Picatout/machineathe/documents/extérieur panneau contrôle.JPG

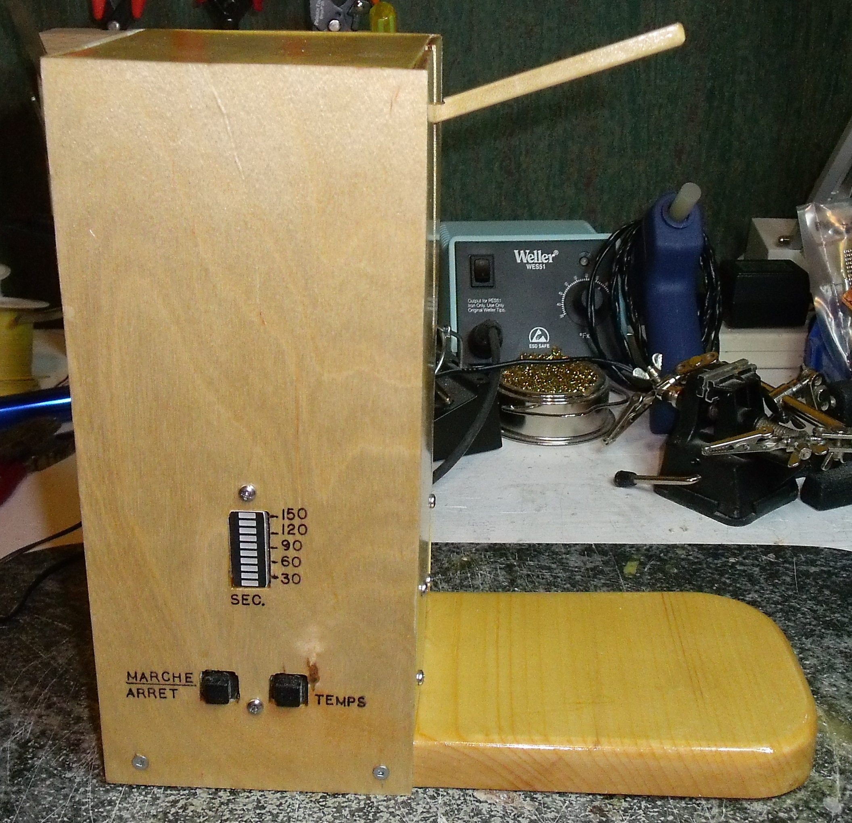
documents/extérieur panneau contrôle.JPG
