Picatout/machineathe/documents/vue 45 avant.JPG

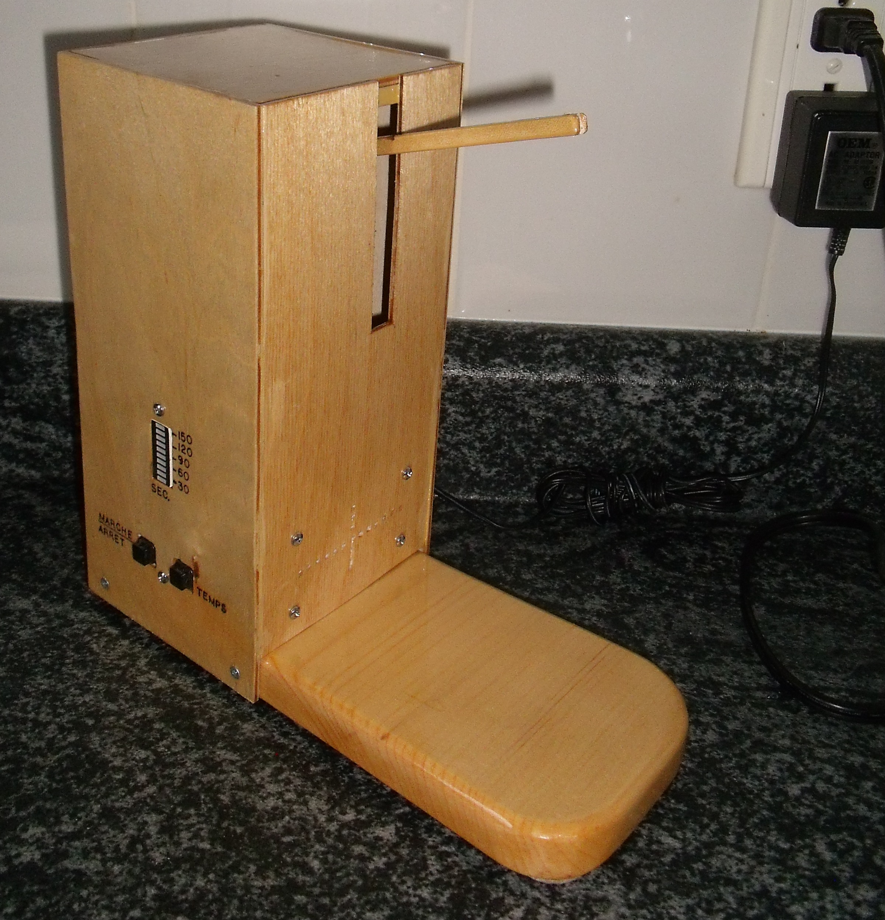
documents/vue 45 avant.JPG
