Picatout/machineathe/README.md

# machineathe
machine qui fait le trempage d'un sachet de thé. Contrôlé par minuterie.

Un bras mécanique contrôlé par un servomoteur descend le sachet dans la tasse au début du trempage et le soulève hors de la tasse à l'expiration de la minuterie.

licence logicielle:  GPLV3
autres documents: CC-BY-SA

# mise à jour révision B

mise à jour mineure. ajout table mélodie SOLDOMI  nouvelle séquence d'alarme.

ajout d'un "easter egg" qui joue l'hymne à la joie de Beethoven

# mise à jour révision C

L'easter egg est devenu une boite à musique avec 8 mélodies.
