Picatout/machineathe/documents/ordinogramme.png

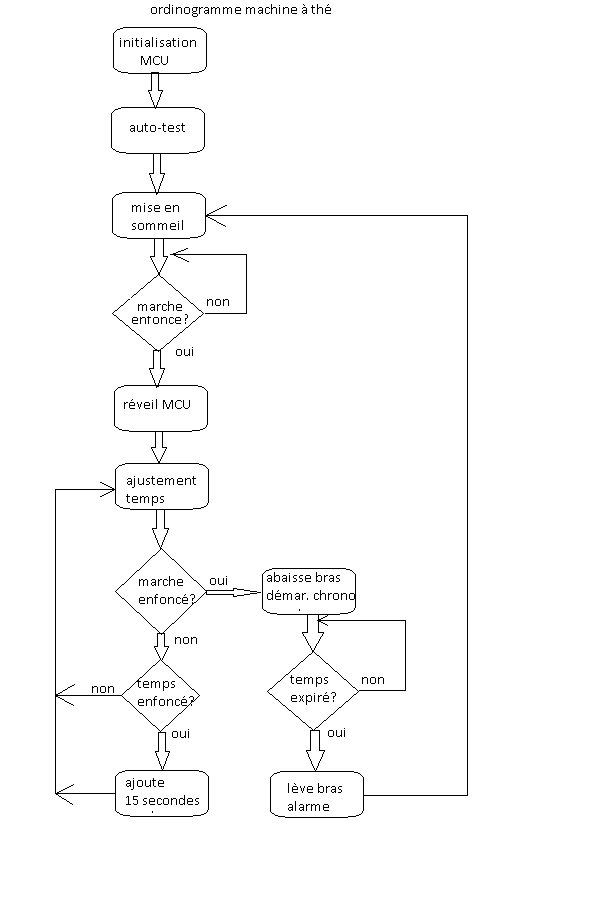
documents/ordinogramme.png
