Picatout/machineathe/KICAD/TDM-schématique.png

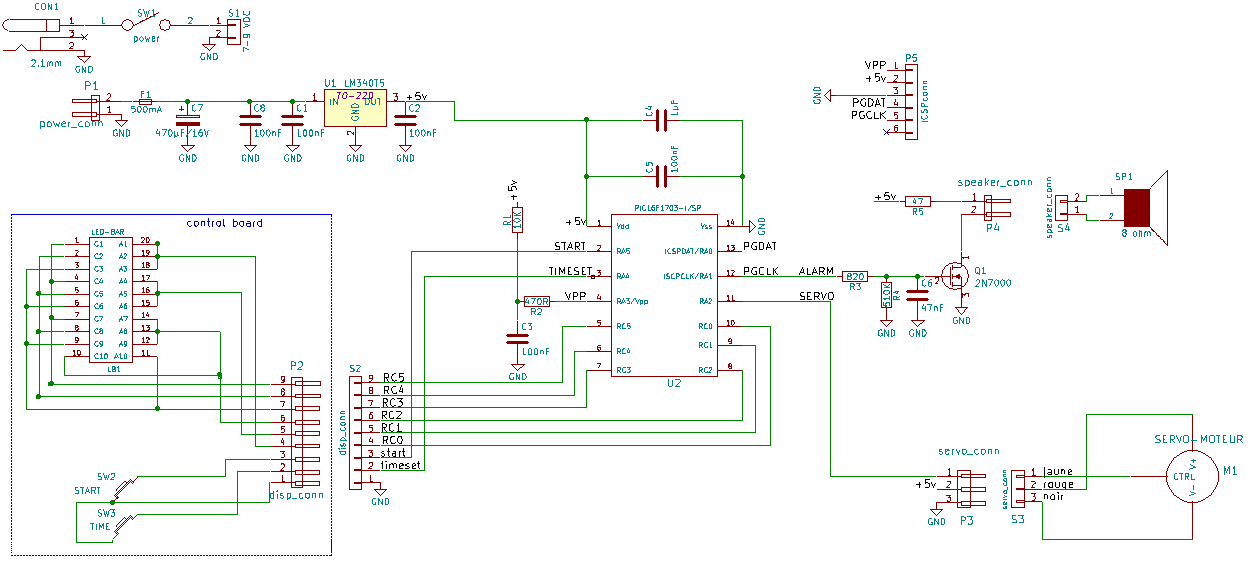
KICAD/TDM-schématique.png
