Picatout/machineathe/KICAD/TDM-schematic.pdf

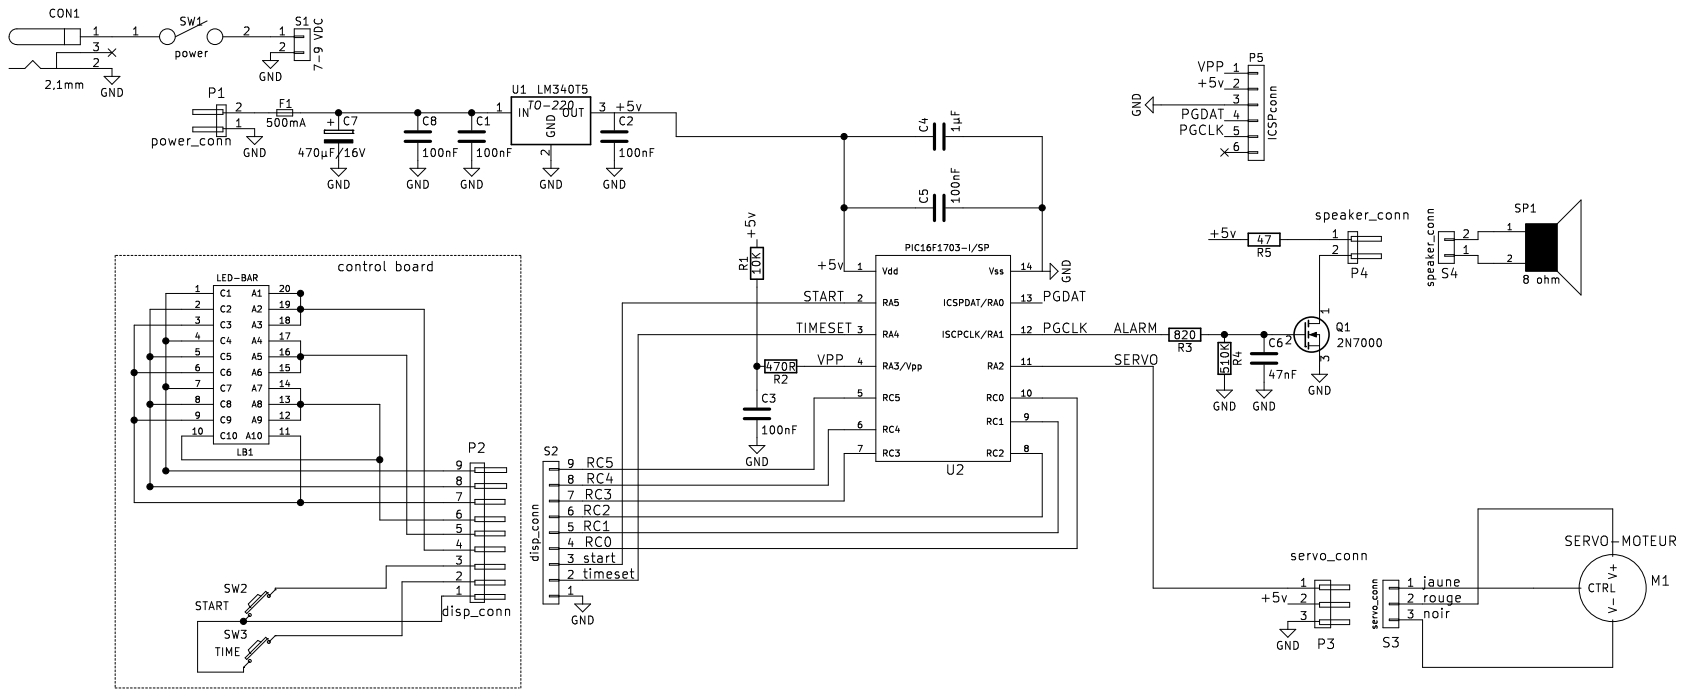
[picture p5: page 1]
