Picatout/machineathe/(commit log)

2016-09-11 mise à jour finale
    [TDM.kicad_pcb, TDM.sch]
2016-09-11 correction bogue dans timeset:
    l'instruction bra $-1 était manquante dans la boucle de contrôle du relâchement du bouton START_PIN
    [mat.asm]
2016-09-12 correction commentaire dans routine alarm:
    [mat.asm]
2016-09-20 changer alarme
    ajout de la table de notes SOLDOMI
    ajout #define ALARM_TABLE et modfiction sous-routine alarm:
2016-09-26 révision C
    ajout de mélodie à la boite à musique
2016-11-22 modifier constante SERVO_POS_BAS et ajouté koromeiniki à la boite à musique
